hkr352/picoKey/README.md

# picoKey

- KMK 

- numeric keypad
- calculator

- kailh low profile key
- Full Color LED
- LCD
