hkr352/picoKey/picoKey_2304_ListByValues.xlsx

Qty | Value | Part Num | Package | Parts
1 |  | * | CHIP-LED0603 | LED0
1 | 2N7002 | * | SOT-23 | Q2 | カラーセレクター
1 | SSM3J332RLF | * | SOT-23 | Q1 | https://akizukidenshi.com/catalog/g/gI-15985/
1 | ピンヘッダ―20*2 | * | RASPBERRYPI_PICO_RPI_PICO_MY | X1
1 | RBE2VAM20ATR | * | SOD-123 | D21 | digikey
19 | 1N4148WS | * | SOD-123 | D1, D2, D3, D5, D6, D7, D8, D9, D10, D11, D12, D13, D14, D15, D16, D17, D18, D19, D20 | akizuki
1 | 1k | * | R0603 | R9
2 | 4.7k | * | R0603 | R5, R6
1 | 100R | * | R0603 | R2
4 | 100k | * | R0603 | R1, R4, R7, R8
1 | 200k | * | R0603 | R3
1 | CHG-4056 | * | CHG-4056 | U1 | ☑
1 | CPG135001D02-SS | * | CPG135001D02-S | S8 | ☑
18 | CPG135001D02V2 | * | KAILH_CHOC_V2 | S1, S2, S3, S5, S6, S7, S9, S10, S11, S12, S13, S14, S15, S16, S17, S18, S19, S20 | ☑
1 | FEATHER_WING_OLED ピンヘッダ5+4pin | * | FEATHER_WING_OLED | U2 | akizuki
19 | SK6812MINI-EH | * | SK6812MINIE-H | LED1, LED2, LED3, LED4, LED5, LED6, LED7, LED8, LED9, LED10, LED11, LED12, LED13, LED14, LED15, LED16, LED17, LED18, LED19 | akizuki
4 | TPTP06R | * | TP06R | TP1, TP2, TP3, TP4 | ☑
