hkr352/picoKey/picoKey_2304.pdf

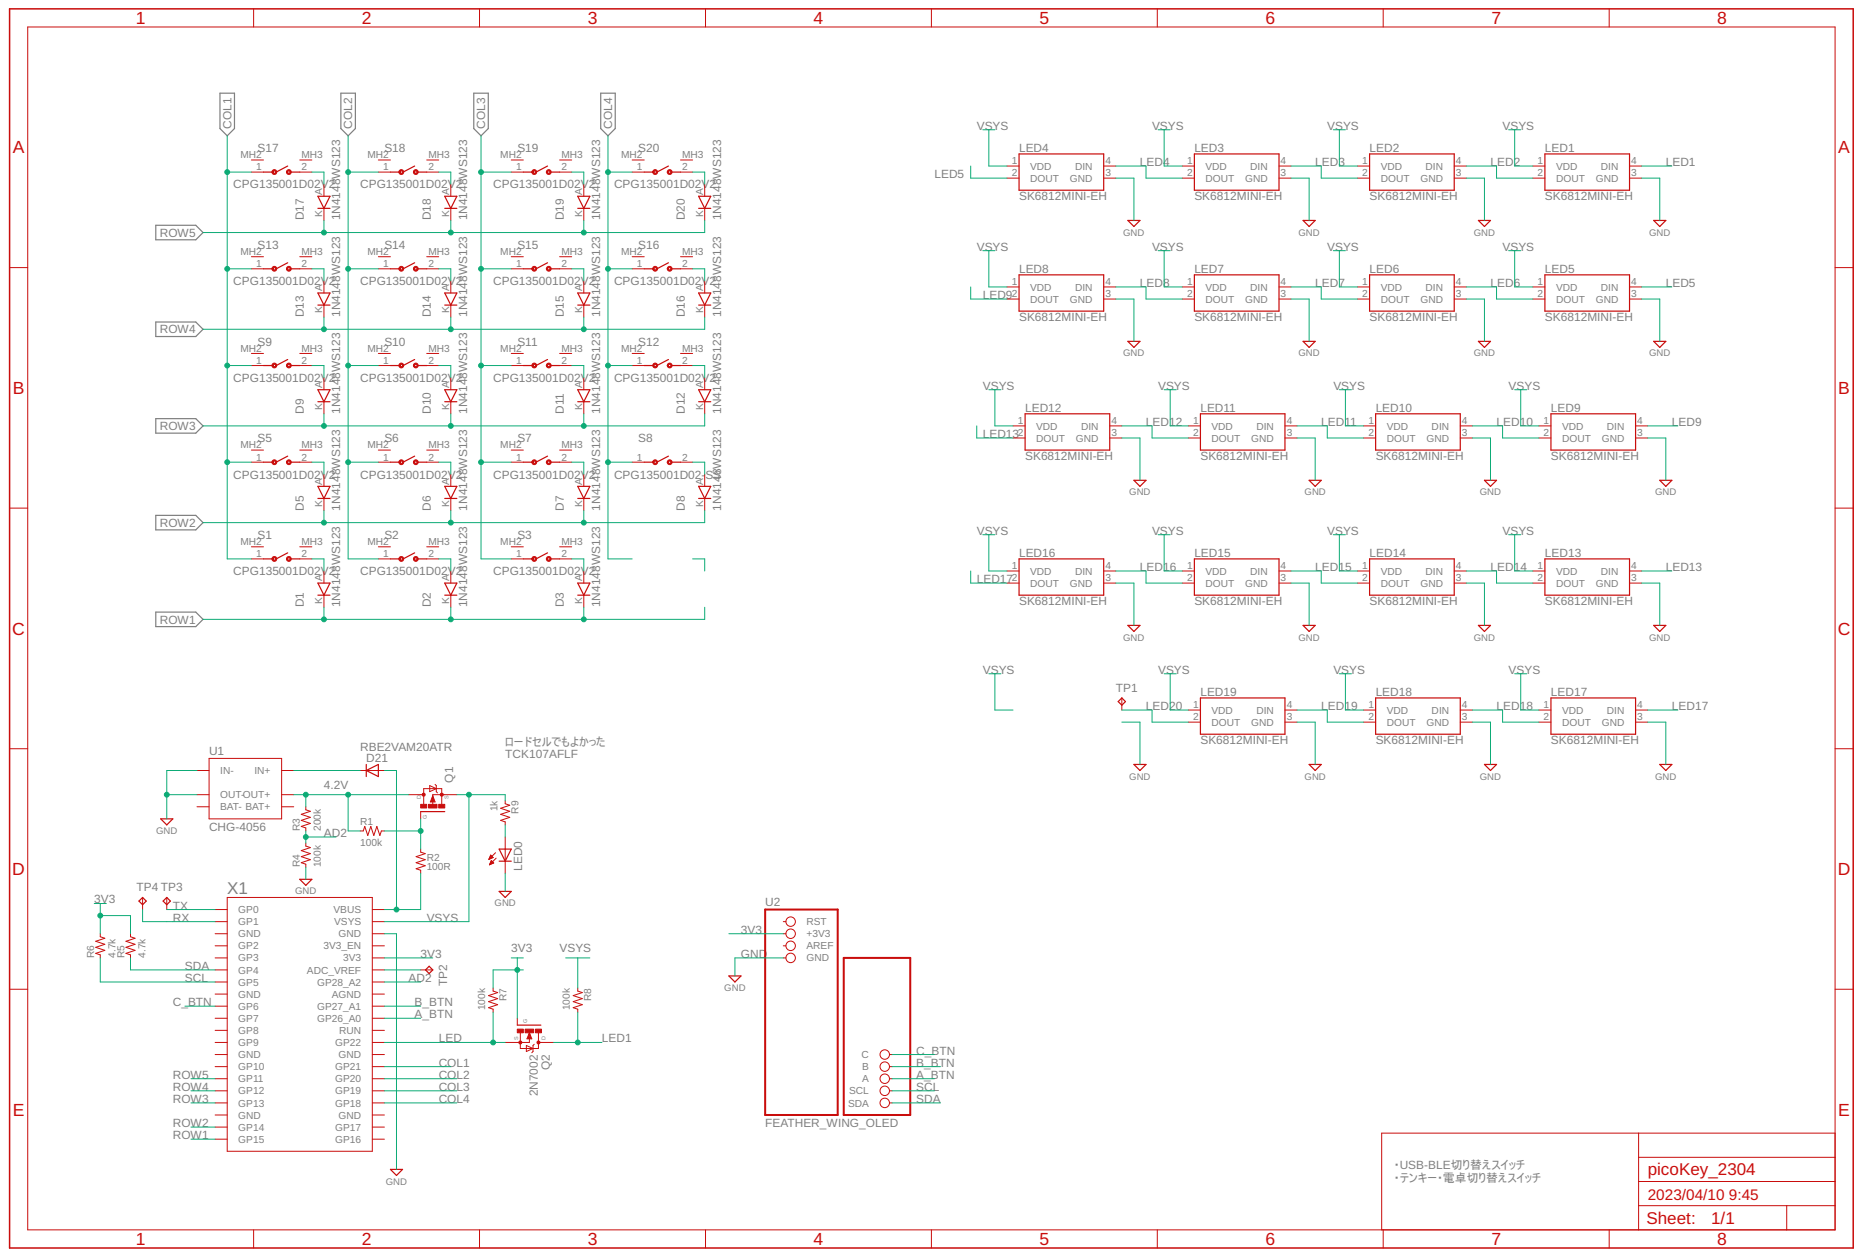
[picture p1: page 1]

IN- OUT- BAT- BAT+ OUT+

・USB-BLE切り替えスイッチ ・テンキー・電卓切り替えスイッチ

Sheet: 1/1
