hkr352/picoKey/(commit log)

2023-04-07 edit enter
    [picoKey_230407-e.brd, picoKey_230407-e.sch, picoKey_230407.brd, picoKey_230407.sch]
2023-04-09 add stabilizer
    [picoKey_230408.brd, picoKey_230408.sch]
2024-02-22 add code
    [nrfKey_2401.brd, nrfKey_2401.sch, picoKey_2304.brd, picoKey_2304.sch, picoKey_230404.brd, picoKey_230404.sch, picoKey_230406.brd, picoKey_230406.sch]
